Saif4embedded/Low-Cost-Bi-Directional-AirFlow-Sensor/Eagle_8.6.0_Files/AirFlow_Sensor.sch

## EAGLE design Eagle_8.6.0_Files/AirFlow_Sensor.sch (2020-03-29)

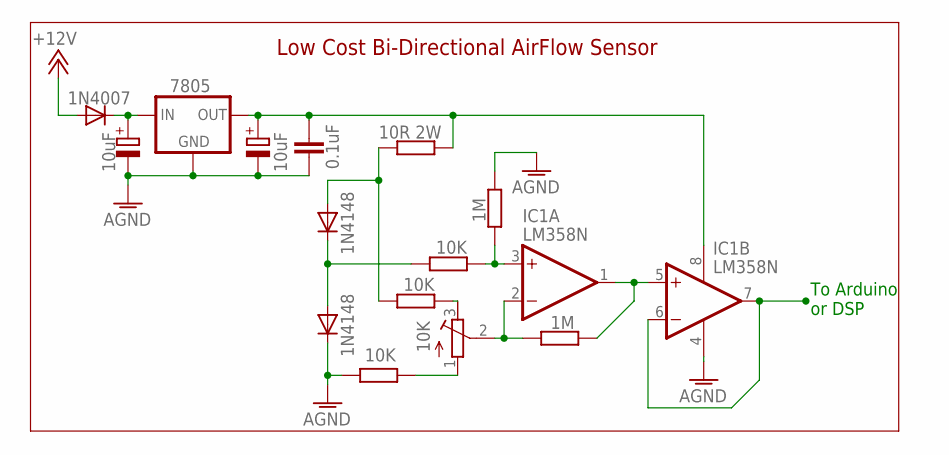
[picture p6: schematic AirFlow_Sensor.sch]

Parts:
C1: 0.1uF; C025-025X050
C2, C4: 10uF; E2,5-6
CALIBRATION: 10K; RTRIM64W
D2, D3: 1N4148; DO35-7
D4: 1N4007; DO41-10
IC1: LM358N; DIL08
IC2: 7805; 78XXL
R1, R4, R7: 10K; 0204/7
R2, R3: 1M; 0204/7
R5: 10R 2W; 0204/7

Connections:
+12V: D4.A
AGND: C1.2, C2.-, C4.-, D2.C, IC1.4 (V-), IC2.GND, R1.1, R3.2
unnamed: IC1.6 (-IN), IC1.7 (OUT)
unnamed: CALIBRATION.2 (S), IC1.2 (-IN), R2.1
unnamed: IC1.1 (OUT), IC1.5 (+IN), R2.2
unnamed: IC1.3 (+IN), R3.1, R4.1
unnamed: CALIBRATION.1 (A), R1.2
unnamed: D3.A, R5.1, R7.2
unnamed: D2.A, D3.C, R4.2
unnamed: C2.+, D4.C, IC2.IN
unnamed: CALIBRATION.3 (E), R7.1
unnamed: C1.1, C4.+, IC1.8 (V+), IC2.OUT, R5.2

Notes on the sheet:
To Arduino or DSP
Low Cost Bi-Directional AirFlow Sensor
